mebrain/merobot/robots/headbot/README.md

# Headbot

Headbot is the head assembly previously called Smallskull. This directory contains
its printable STL meshes: the body, central column, ESP32 camera cover and holder,
and LED eye holder. A structure description and simulation have not been added yet.
