mebrain/merobot/robot_structure.md

# merobot – Robot Structure

Notation: see [merobot_spec.md](merobot_spec.md).

_Draft: middle (servos 3–8) to be corrected._

```
                    ┌───────────────────────────────┐
                    │                               │
                    │            head_box           │
                    └─────────────┐   ┌─────────────┘
                                  ↑ ○ ↑
                             ┌────┘   └────┐
                             │             │
                             │   servo 1   │
                             ├──────=──────┤
                             │             │
                             │   servo 2   │
                             └────┐   ┌────┘
                                  ↓   ↓
                                  ○   ○
                    ┌─────────────┘   └─────────────┐
                    │          { imu_body }         │
                    │            box_body           │
                    ├──────=──────┬───┬──────=──────┤
                    │   servo 3   │   │   servo 4   │
                    └────┐   ┌────┘   └────┐   ┌────┘
                         ↓ ○ ↓             ↓ ○ ↓
                    ┌────┘   └────┐   ┌────┘   └────┐
┌─────────────┐     │             │   │             │     ┌─────────────┐
│   servo 5   │ ○←──┤   servo 6   │   │   servo 7   ├──→○ │   servo 8   │
├──────⊙──────┤     └─────────────┘   └─────────────┘     ├──────⊙──────┤
│             │                                           │             │
│   servo 9   │                                           │   servo 10  │
└────┐   ┌────┘                                           └────┐   ┌────┘
     ↓   ↓                                                     ↓   ↓
     ○   ○                                                     ○   ○
┌────┘   └────┐                                           ┌────┘   └────┐
│             │                                           │             │
│   servo 11  │                                           │   servo 12  │
└────┐   ┌────┘                                           └────┐   ┌────┘
     ↓   ↓                                                     ↓   ↓
     ○   ○                                                     ○   ○
┌────┘   └────┐                                           ┌────┘   └────┐
│     foot    │                                           │     foot    │
└─────────────┘                                           └─────────────┘
```
