mebrain/merobot/robots/headbot/MainBody.stl

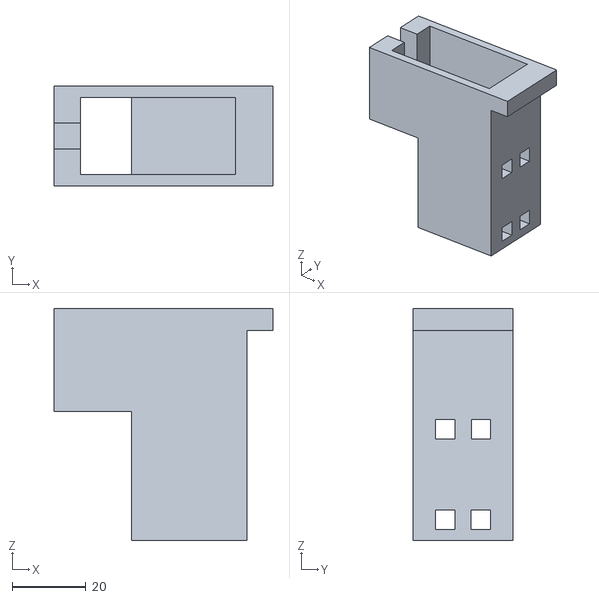
[picture p16: CAD file, 2026-10-18]
robots/headbot/MainBody.stl
59.4 x 27.1 x 63.0
