mebrain/merobot/components/boards/esp32.3mf

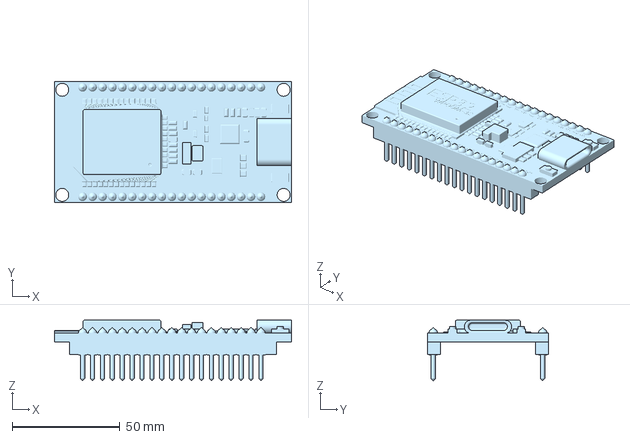
[picture p17: CAD file, 2026-10-18]
components/boards/esp32.3mf
110.0 x 56.0 x 28.1 mm
