mebrain/merobot/components/servos/XL430_W250_T.stl

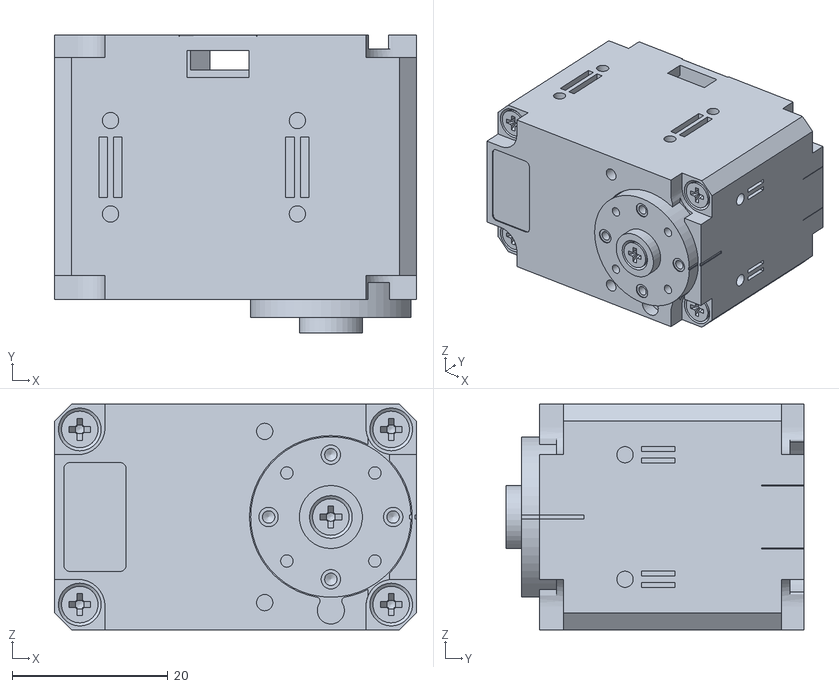
[picture p18: CAD file, 2026-10-18]
components/servos/XL430_W250_T.stl
46.5 x 38.3 x 29.0
