mebrain/merobot/robots/duckbot/parts/servo_holder.stl

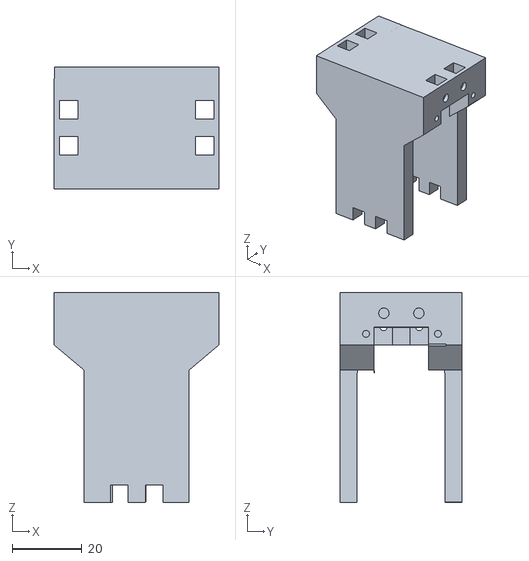
[picture p19: CAD file, 2026-10-11]
robots/duckbot/parts/servo_holder.stl
47.1 x 35.0 x 60.0
