mebrain/merobot/robots/headbot/EspHolder.stl

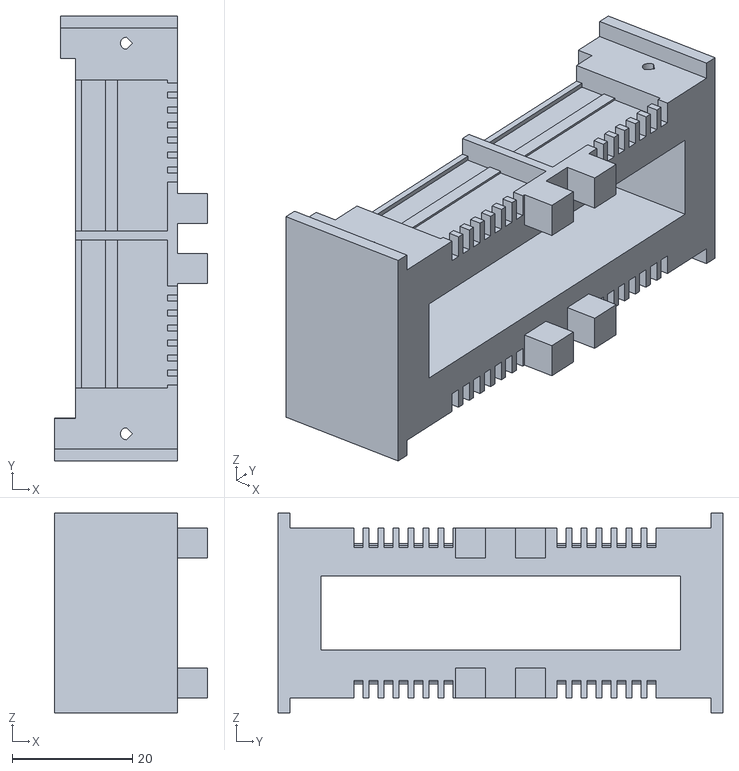
[picture p20: CAD file, 2026-10-18]
robots/headbot/EspHolder.stl
25.5 x 74.0 x 33.3
