mebrain/merobot/components/servos/MG996R_Servo.stl

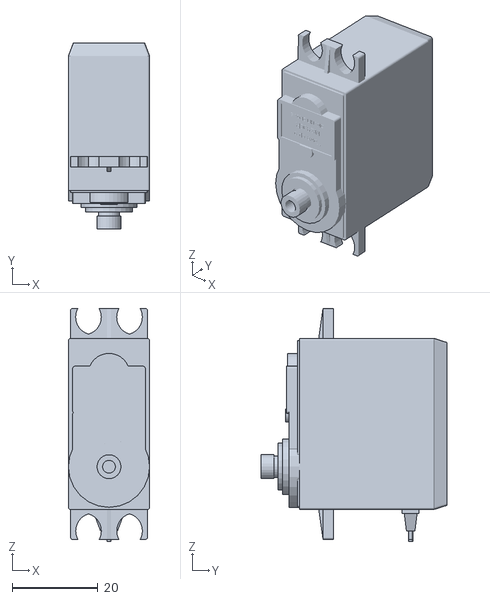
[picture p21: CAD file, 2026-10-18]
components/servos/MG996R_Servo.stl
19.0 x 43.5 x 54.5
