mebrain/merobot/robots/duckbot/parts/foot.stl

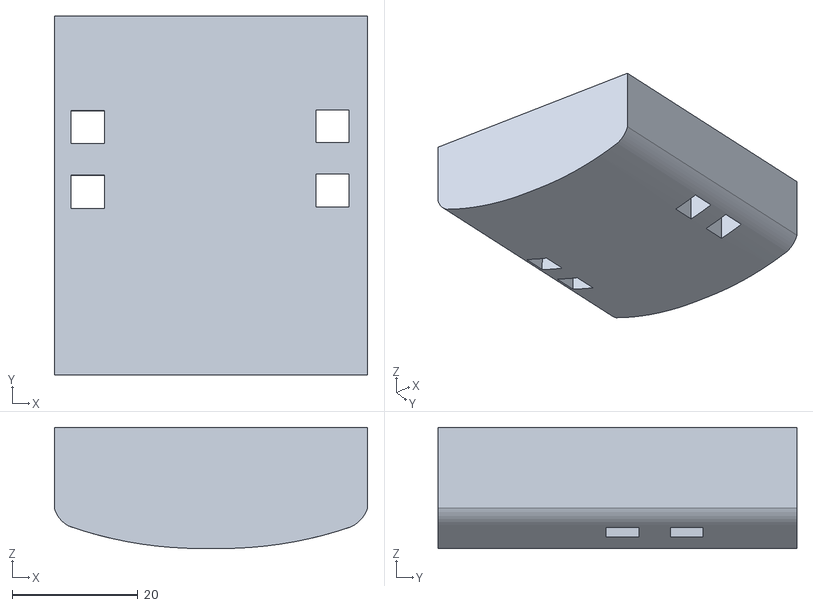
[picture p22: CAD file, 2026-10-11]
robots/duckbot/parts/foot.stl
49.8 x 57.0 x 19.2
