mebrain/merobot/robots/headbot/LEDEyeHolder.stl

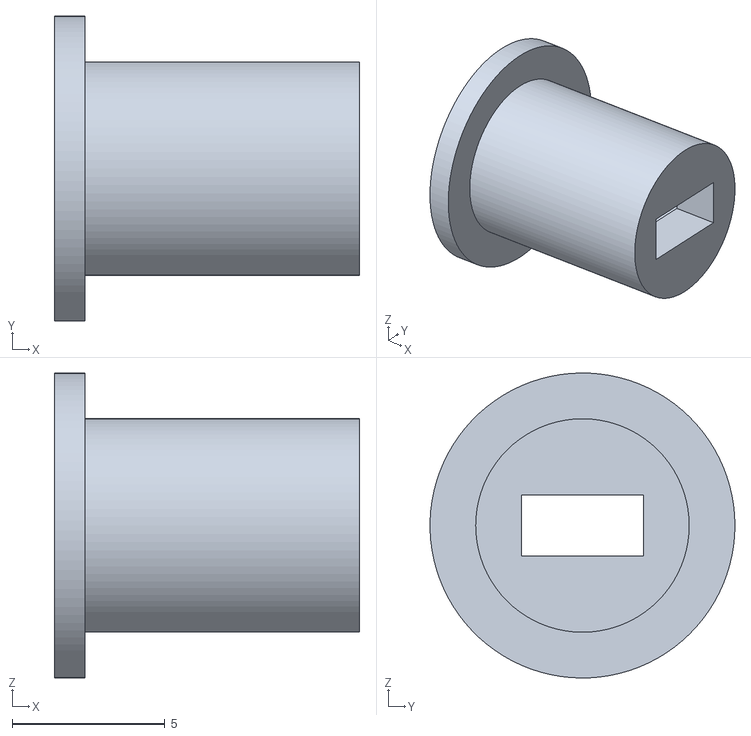
[picture p23: CAD file, 2026-10-18]
robots/headbot/LEDEyeHolder.stl
10.0 x 10.00 x 10.00
