mebrain/merobot/robots/duckbot/parts/connecting_rod.stl

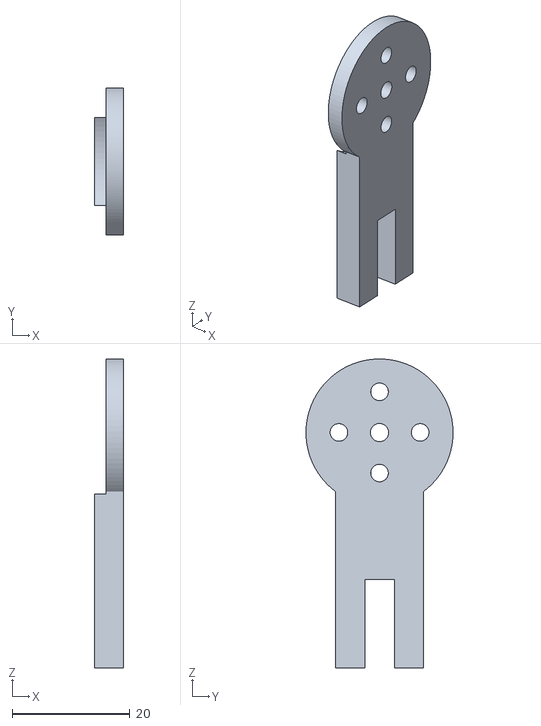
[picture p24: CAD file, 2026-10-11]
robots/duckbot/parts/connecting_rod.stl
5.00 x 25.0 x 52.5
