mebrain/merobot/robots/headbot/ESP-32-Cam-Cover.stl

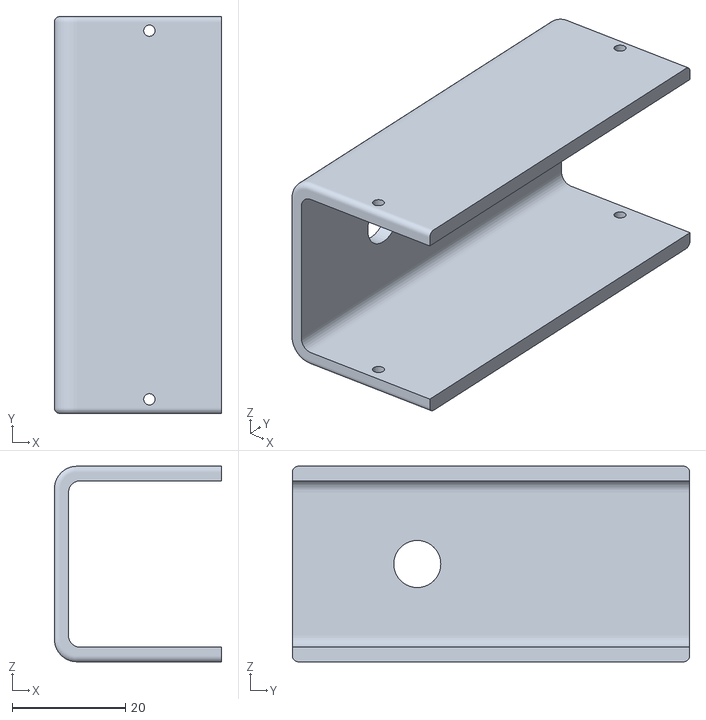
[picture p25: CAD file, 2026-10-18]
robots/headbot/ESP-32-Cam-Cover.stl
29.5 x 70.0 x 34.5
