mebrain/merobot/robots/headbot/Body13.stl

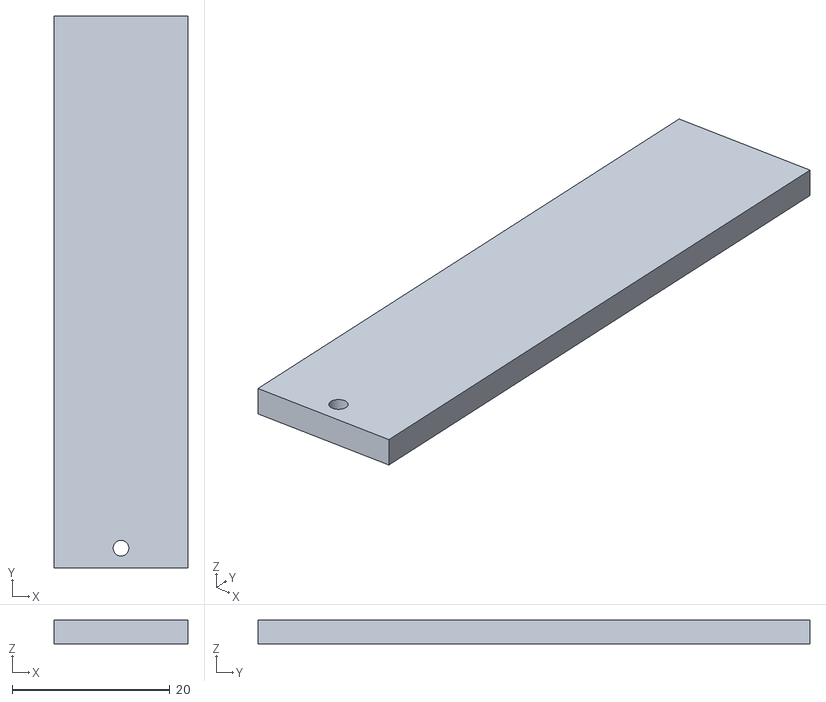
[picture p26: CAD file, 2026-10-18]
robots/headbot/Body13.stl
17.0 x 70.0 x 3.00
