mebrain/merobot/robots/headbot/CentralColumn.stl

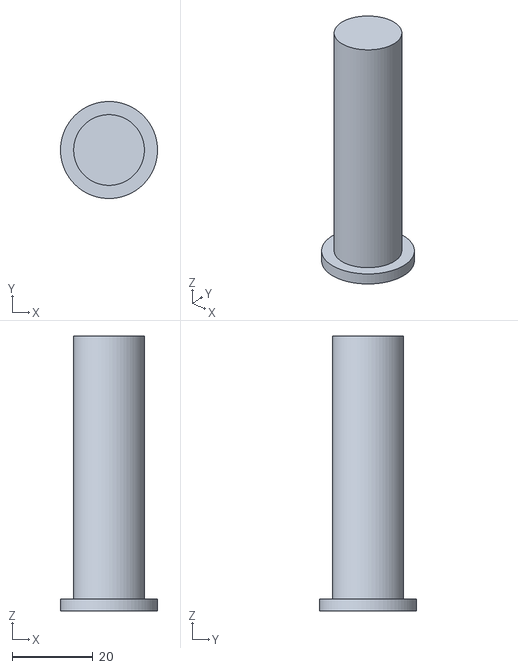
[picture p27: CAD file, 2026-10-18]
robots/headbot/CentralColumn.stl
24.0 x 24.0 x 68.0
