mebrain/merobot/merobot.xml

<!--
  merobot - generated by generate_mjcf.py from parts/*.json and robot_structure.md. Do not edit by hand.

  World frame: x = our right (looking at the robot from the front), y = away from us
  (the robot faces -y), z = up. Each joint is named after the servo that drives it.
  Servo model: STS3215 7.4V (stall 1.91 N*m, damping 0.434 = stall torque / no-load speed,
  armature 0.012 kg*m^2, response lag 0.02 s).
  box_body has a freejoint: the robot stands on the floor and can fall.
-->
<mujoco model="merobot">
  <compiler angle="degree" meshdir="parts" inertiafromgeom="true"/>
  <option timestep="0.002" integrator="implicitfast"/>

  <visual>
    <global offwidth="1600" offheight="1200"/>
    <headlight ambient=".35 .35 .35" diffuse=".5 .5 .5"/>
  </visual>

  <default>
    <geom contype="0" conaffinity="1"/>  <!-- parts touch the floor, not each other -->
    <joint type="hinge" range="-90.0 90.0" damping="0.4341" armature="0.012" frictionloss="0.05"/>
    <position kp="20.0" ctrlrange="-1.57 1.57" forcerange="-1.91 1.91" timeconst="0.02"/>
    <default class="visual">
      <geom material="pla"/>
    </default>
    <default class="rotor">
      <geom size="0.008 0.001" material="rotor" mass="0" conaffinity="0"/>
    </default>
  </default>

  <asset>
    <mesh name="servo_holder" file="servo_holder.stl" scale="0.001 0.001 0.001" inertia="convex"/>
    <mesh name="connecting_rod" file="connecting_rod.stl" scale="0.001 0.001 0.001" inertia="convex"/>
    <mesh name="foot" file="foot.stl" scale="0.001 0.001 0.001" inertia="convex"/>
    <texture type="skybox" builtin="gradient" rgb1=".55 .6 .68" rgb2=".15 .17 .2" width="512" height="512"/>
    <texture name="grid" type="2d" builtin="checker" rgb1=".2 .25 .3" rgb2=".25 .3 .35" width="300" height="300" mark="edge" markrgb=".4 .45 .5"/>
    <material name="grid" texture="grid" texrepeat="8 8" reflectance=".1"/>
    <material name="pla" rgba=".72 .75 .8 1"/>
    <material name="servo" rgba=".12 .12 .14 1"/>
    <material name="box" rgba=".55 .6 .66 1"/>
    <material name="rod" rgba=".95 .55 .15 1"/>
    <material name="foot" rgba=".95 .45 .1 1"/>
    <material name="rotor" rgba=".95 .95 .95 1"/>
  </asset>

  <worldbody>
    <light pos="0.3 -0.6 0.8" dir="-0.3 0.6 -0.8" diffuse=".8 .8 .8"/>
    <light pos="-0.4 0.3 0.6" dir="0.4 -0.3 -0.6" diffuse=".3 .3 .3"/>
    <geom name="floor" type="plane" size="0.6 0.6 0.01" material="grid" contype="1" conaffinity="1"/>
    <body name="box_body" pos="0 0 0.27085">
      <freejoint name="root"/>
      <geom name="box_body" type="box" material="box" class="visual" size="0.0625 0.025 0.035" mass="0.15"/>
      <geom name="rod_servo2_a" type="mesh" mesh="connecting_rod" material="rod" class="visual" pos="-0.02629 -0.0193 -0.00715" quat="1 0 0 0" mass="0.0038"/>
      <geom name="rod_servo2_b" type="mesh" mesh="connecting_rod" material="rod" class="visual" pos="0.02629 0.0193 -0.00715" quat="0 0 0 1" mass="0.0038"/>
      <site name="imu_body" pos="0 0 0" size="0.006" rgba="0 .8 1 1"/>
      <body name="servo2" pos="0 0 0.0605">
        <joint name="servo2" pos="0 0 0" axis="1 0 0"/>
        <geom name="servo2_holder" type="mesh" mesh="servo_holder" class="visual" pos="-0.02385 -0.0309 -0.0354" quat="1 0 0 0" mass="0.04"/>
        <geom name="servo2_sts3215" type="box" material="servo" class="visual" pos="0 0 0.0116" quat="1 0 0 0" size="0.0175 0.01235 0.0226" mass="0.055"/>
        <geom type="cylinder" class="rotor" pos="0.0185 0 0" zaxis="1 0 0"/>
        <geom type="cylinder" class="rotor" pos="-0.0185 0 0" zaxis="1 0 0"/>
        <body name="servo1" pos="-0.014 0 0.06755">
          <geom name="servo1_holder" type="mesh" mesh="servo_holder" class="visual" pos="-0.0354 0.0309 -0.02385" quat="0 0.70711 0 0.70711" mass="0.04"/>
          <geom name="servo1_sts3215" type="box" material="servo" class="visual" pos="0.0116 0 0" quat="0 0.70711 0 0.70711" size="0.0175 0.01235 0.0226" mass="0.055"/>
          <geom type="cylinder" class="rotor" pos="0 0 0.0185" zaxis="0 0 1"/>
          <geom type="cylinder" class="rotor" pos="0 0 -0.0185" zaxis="0 0 1"/>
          <body name="head_box" pos="0.014 0 0.06355">
            <joint name="servo1" pos="-0.014 0 -0.06355" axis="0 0 1"/>
            <geom name="head_box" type="box" material="box" class="visual" size="0.0625 0.025 0.035" mass="0.08"/>
          </body>
        </body>
      </body>
      <body name="servo3" pos="-0.0465 0 -0.05855">
        <geom name="servo3_holder" type="mesh" mesh="servo_holder" class="visual" pos="-0.0354 -0.0309 0.02385" quat="0.70711 0 0.70711 0" mass="0.04"/>
        <geom name="servo3_sts3215" type="box" material="servo" class="visual" pos="0.0116 0 0" quat="0.70711 0 0.70711 0" size="0.0175 0.01235 0.0226" mass="0.055"/>
        <geom type="cylinder" class="rotor" pos="0 0 -0.0185" zaxis="0 0 -1"/>
        <geom type="cylinder" class="rotor" pos="0 0 0.0185" zaxis="0 0 -1"/>
        <body name="servo6" pos="0 0 -0.07255">
          <joint name="servo3" pos="0 0 0.07255" axis="0 0 -1"/>
          <geom name="servo6_holder" type="mesh" mesh="servo_holder" class="visual" pos="-0.0309 0.02385 -0.0354" quat="0.70711 0 0 -0.70711" mass="0.04"/>
          <geom name="servo6_sts3215" type="box" material="servo" class="visual" pos="0 0 0.0116" quat="0.70711 0 0 -0.70711" size="0.0175 0.01235 0.0226" mass="0.055"/>
          <geom type="cylinder" class="rotor" pos="0 -0.0185 0" zaxis="0 -1 0"/>
          <geom type="cylinder" class="rotor" pos="0 0.0185 0" zaxis="0 -1 0"/>
          <body name="servo5" pos="-0.0665 0 0.0015">
            <joint name="servo6" pos="0.0665 0 -0.0015" axis="0 -1 0"/>
            <geom name="servo5_holder" type="mesh" mesh="servo_holder" class="visual" pos="-0.0354 0.02385 0.0309" quat="-0.5 0.5 -0.5 0.5" mass="0.04"/>
            <geom name="servo5_sts3215" type="box" material="servo" class="visual" pos="0.0116 0 0" quat="-0.5 0.5 -0.5 0.5" size="0.0175 0.01235 0.0226" mass="0.055"/>
            <geom type="cylinder" class="rotor" pos="0 -0.0185 0" zaxis="0 -1 0"/>
            <geom type="cylinder" class="rotor" pos="0 0.0185 0" zaxis="0 -1 0"/>
            <body name="servo9" pos="0.014 0.04105 -0.0265">
              <geom name="servo9_holder" type="mesh" mesh="servo_holder" class="visual" pos="-0.02385 -0.0309 -0.0354" quat="1 0 0 0" mass="0.04"/>
              <geom name="servo9_sts3215" type="box" material="servo" class="visual" pos="0 0 0.0116" quat="1 0 0 0" size="0.0175 0.01235 0.0226" mass="0.055"/>
              <geom type="cylinder" class="rotor" pos="0.0185 0 0" zaxis="1 0 0"/>
              <geom type="cylinder" class="rotor" pos="-0.0185 0 0" zaxis="1 0 0"/>
              <body name="servo11" pos="0 0 -0.0695">
                <joint name="servo9" pos="0 0 0.0695" axis="1 0 0"/>
                <geom name="servo11_holder" type="mesh" mesh="servo_holder" class="visual" pos="-0.02385 -0.0309 -0.0354" quat="1 0 0 0" mass="0.04"/>
                <geom name="servo11_sts3215" type="box" material="servo" class="visual" pos="0 0 0.0116" quat="1 0 0 0" size="0.0175 0.01235 0.0226" mass="0.055"/>
                <geom type="cylinder" class="rotor" pos="0.0185 0 0" zaxis="1 0 0"/>
                <geom type="cylinder" class="rotor" pos="-0.0185 0 0" zaxis="1 0 0"/>
                <geom name="rod_servo9_a" type="mesh" mesh="connecting_rod" material="rod" class="visual" pos="-0.02629 -0.0193 0.00185" quat="1 0 0 0" mass="0.0038"/>
                <geom name="rod_servo9_b" type="mesh" mesh="connecting_rod" material="rod" class="visual" pos="0.02629 0.0193 0.00185" quat="0 0 0 1" mass="0.0038"/>
                <body name="foot_left" pos="0 0 -0.0255">
                  <joint name="servo11" pos="0 0 0.0255" axis="1 0 0"/>
                  <geom name="foot_left" type="mesh" mesh="foot" material="foot" pos="-0.025325 -0.03385 0.00325" mass="0.0603"/>
                  <geom name="rod_servo11_a" type="mesh" mesh="connecting_rod" material="rod" class="visual" pos="-0.02629 -0.0193 -0.04215" quat="1 0 0 0" mass="0.0038"/>
                  <geom name="rod_servo11_b" type="mesh" mesh="connecting_rod" material="rod" class="visual" pos="0.02629 0.0193 -0.04215" quat="0 0 0 1" mass="0.0038"/>
                </body>
              </body>
            </body>
          </body>
        </body>
      </body>
      <body name="servo4" pos="0.0465 0 -0.05855">
        <geom name="servo4_holder" type="mesh" mesh="servo_holder" class="visual" pos="0.0354 0.0309 0.02385" quat="0 0.70711 0 -0.70711" mass="0.04"/>
        <geom name="servo4_sts3215" type="box" material="servo" class="visual" pos="-0.0116 0 0" quat="0 0.70711 0 -0.70711" size="0.0175 0.01235 0.0226" mass="0.055"/>
        <geom type="cylinder" class="rotor" pos="0 0 -0.0185" zaxis="0 0 -1"/>
        <geom type="cylinder" class="rotor" pos="0 0 0.0185" zaxis="0 0 -1"/>
        <body name="servo7" pos="0 0 -0.07255">
          <joint name="servo4" pos="0 0 0.07255" axis="0 0 -1"/>
          <geom name="servo7_holder" type="mesh" mesh="servo_holder" class="visual" pos="-0.0309 0.02385 -0.0354" quat="0.70711 0 0 -0.70711" mass="0.04"/>
          <geom name="servo7_sts3215" type="box" material="servo" class="visual" pos="0 0 0.0116" quat="0.70711 0 0 -0.70711" size="0.0175 0.01235 0.0226" mass="0.055"/>
          <geom type="cylinder" class="rotor" pos="0 -0.0185 0" zaxis="0 -1 0"/>
          <geom type="cylinder" class="rotor" pos="0 0.0185 0" zaxis="0 -1 0"/>
          <body name="servo8" pos="0.0665 0 0.0015">
            <joint name="servo7" pos="-0.0665 0 -0.0015" axis="0 -1 0"/>
            <geom name="servo8_holder" type="mesh" mesh="servo_holder" class="visual" pos="0.0354 0.02385 -0.0309" quat="0.5 0.5 -0.5 -0.5" mass="0.04"/>
            <geom name="servo8_sts3215" type="box" material="servo" class="visual" pos="-0.0116 0 0" quat="0.5 0.5 -0.5 -0.5" size="0.0175 0.01235 0.0226" mass="0.055"/>
            <geom type="cylinder" class="rotor" pos="0 -0.0185 0" zaxis="0 -1 0"/>
            <geom type="cylinder" class="rotor" pos="0 0.0185 0" zaxis="0 -1 0"/>
            <body name="servo10" pos="-0.014 0.04105 -0.0265">
              <geom name="servo10_holder" type="mesh" mesh="servo_holder" class="visual" pos="-0.02385 -0.0309 -0.0354" quat="1 0 0 0" mass="0.04"/>
              <geom name="servo10_sts3215" type="box" material="servo" class="visual" pos="0 0 0.0116" quat="1 0 0 0" size="0.0175 0.01235 0.0226" mass="0.055"/>
              <geom type="cylinder" class="rotor" pos="0.0185 0 0" zaxis="1 0 0"/>
              <geom type="cylinder" class="rotor" pos="-0.0185 0 0" zaxis="1 0 0"/>
              <body name="servo12" pos="0 0 -0.0695">
                <joint name="servo10" pos="0 0 0.0695" axis="1 0 0"/>
                <geom name="servo12_holder" type="mesh" mesh="servo_holder" class="visual" pos="-0.02385 -0.0309 -0.0354" quat="1 0 0 0" mass="0.04"/>
                <geom name="servo12_sts3215" type="box" material="servo" class="visual" pos="0 0 0.0116" quat="1 0 0 0" size="0.0175 0.01235 0.0226" mass="0.055"/>
                <geom type="cylinder" class="rotor" pos="0.0185 0 0" zaxis="1 0 0"/>
                <geom type="cylinder" class="rotor" pos="-0.0185 0 0" zaxis="1 0 0"/>
                <geom name="rod_servo10_a" type="mesh" mesh="connecting_rod" material="rod" class="visual" pos="-0.02629 -0.0193 0.00185" quat="1 0 0 0" mass="0.0038"/>
                <geom name="rod_servo10_b" type="mesh" mesh="connecting_rod" material="rod" class="visual" pos="0.02629 0.0193 0.00185" quat="0 0 0 1" mass="0.0038"/>
                <body name="foot_right" pos="0 0 -0.0255">
                  <joint name="servo12" pos="0 0 0.0255" axis="1 0 0"/>
                  <geom name="foot_right" type="mesh" mesh="foot" material="foot" pos="-0.025325 -0.03385 0.00325" mass="0.0603"/>
                  <geom name="rod_servo12_a" type="mesh" mesh="connecting_rod" material="rod" class="visual" pos="-0.02629 -0.0193 -0.04215" quat="1 0 0 0" mass="0.0038"/>
                  <geom name="rod_servo12_b" type="mesh" mesh="connecting_rod" material="rod" class="visual" pos="0.02629 0.0193 -0.04215" quat="0 0 0 1" mass="0.0038"/>
                </body>
              </body>
            </body>
          </body>
        </body>
      </body>
    </body>
  </worldbody>

  <actuator>
    <position name="servo1" joint="servo1"/>
    <position name="servo2" joint="servo2"/>
    <position name="servo3" joint="servo3"/>
    <position name="servo4" joint="servo4"/>
    <position name="servo6" joint="servo6"/>
    <position name="servo7" joint="servo7"/>
    <position name="servo9" joint="servo9"/>
    <position name="servo10" joint="servo10"/>
    <position name="servo11" joint="servo11"/>
    <position name="servo12" joint="servo12"/>
  </actuator>

  <!-- From sensors.json. Noise values are standard deviations; MuJoCo does not apply them itself. -->
  <sensor>
    <gyro name="imu_body_gyro" site="imu_body" noise="0.00058"/>
    <accelerometer name="imu_body_accel" site="imu_body" noise="0.026"/>
    <jointpos name="servo1_pos" joint="servo1"/>
    <jointvel name="servo1_vel" joint="servo1"/>
    <actuatorfrc name="servo1_load" actuator="servo1"/>
    <jointpos name="servo2_pos" joint="servo2"/>
    <jointvel name="servo2_vel" joint="servo2"/>
    <actuatorfrc name="servo2_load" actuator="servo2"/>
    <jointpos name="servo3_pos" joint="servo3"/>
    <jointvel name="servo3_vel" joint="servo3"/>
    <actuatorfrc name="servo3_load" actuator="servo3"/>
    <jointpos name="servo4_pos" joint="servo4"/>
    <jointvel name="servo4_vel" joint="servo4"/>
    <actuatorfrc name="servo4_load" actuator="servo4"/>
    <jointpos name="servo6_pos" joint="servo6"/>
    <jointvel name="servo6_vel" joint="servo6"/>
    <actuatorfrc name="servo6_load" actuator="servo6"/>
    <jointpos name="servo7_pos" joint="servo7"/>
    <jointvel name="servo7_vel" joint="servo7"/>
    <actuatorfrc name="servo7_load" actuator="servo7"/>
    <jointpos name="servo9_pos" joint="servo9"/>
    <jointvel name="servo9_vel" joint="servo9"/>
    <actuatorfrc name="servo9_load" actuator="servo9"/>
    <jointpos name="servo10_pos" joint="servo10"/>
    <jointvel name="servo10_vel" joint="servo10"/>
    <actuatorfrc name="servo10_load" actuator="servo10"/>
    <jointpos name="servo11_pos" joint="servo11"/>
    <jointvel name="servo11_vel" joint="servo11"/>
    <actuatorfrc name="servo11_load" actuator="servo11"/>
    <jointpos name="servo12_pos" joint="servo12"/>
    <jointvel name="servo12_vel" joint="servo12"/>
    <actuatorfrc name="servo12_load" actuator="servo12"/>
  </sensor>
</mujoco>
