mebrain/merobot/(commit log)

2026-10-18 Organize Duckbot and Headbot designs under robots and document standard
    [Body13.stl, CentralColumn.stl, ESP-32-Cam-Cover.stl, EspHolder.stl, LEDEyeHolder.stl, MG996R_Servo.stl, MainBody.stl, XL430_W250_T.stl]
2026-10-23 Publish current 5x5 standard with centered alignment replacing old edge rule
2026-10-23 Allow limited bottom relief for edge-aligned notches to print flat
2026-10-23 Add assembled examples of edge-aligned clearance
2026-10-23 Specify underside cable channels 3mm deep and 2mm wide
2026-10-23 Document grid fitting-hole attachment option
2026-10-24 Fix grid receiving geometry and specify fitting-hole depth
